Galacs/rpi-canfd-pwr-hat/rpi-canfd-pwr-hat.kicad_pcb

## KiCad design rpi-canfd-pwr-hat.kicad_pcb (2026-06-29)

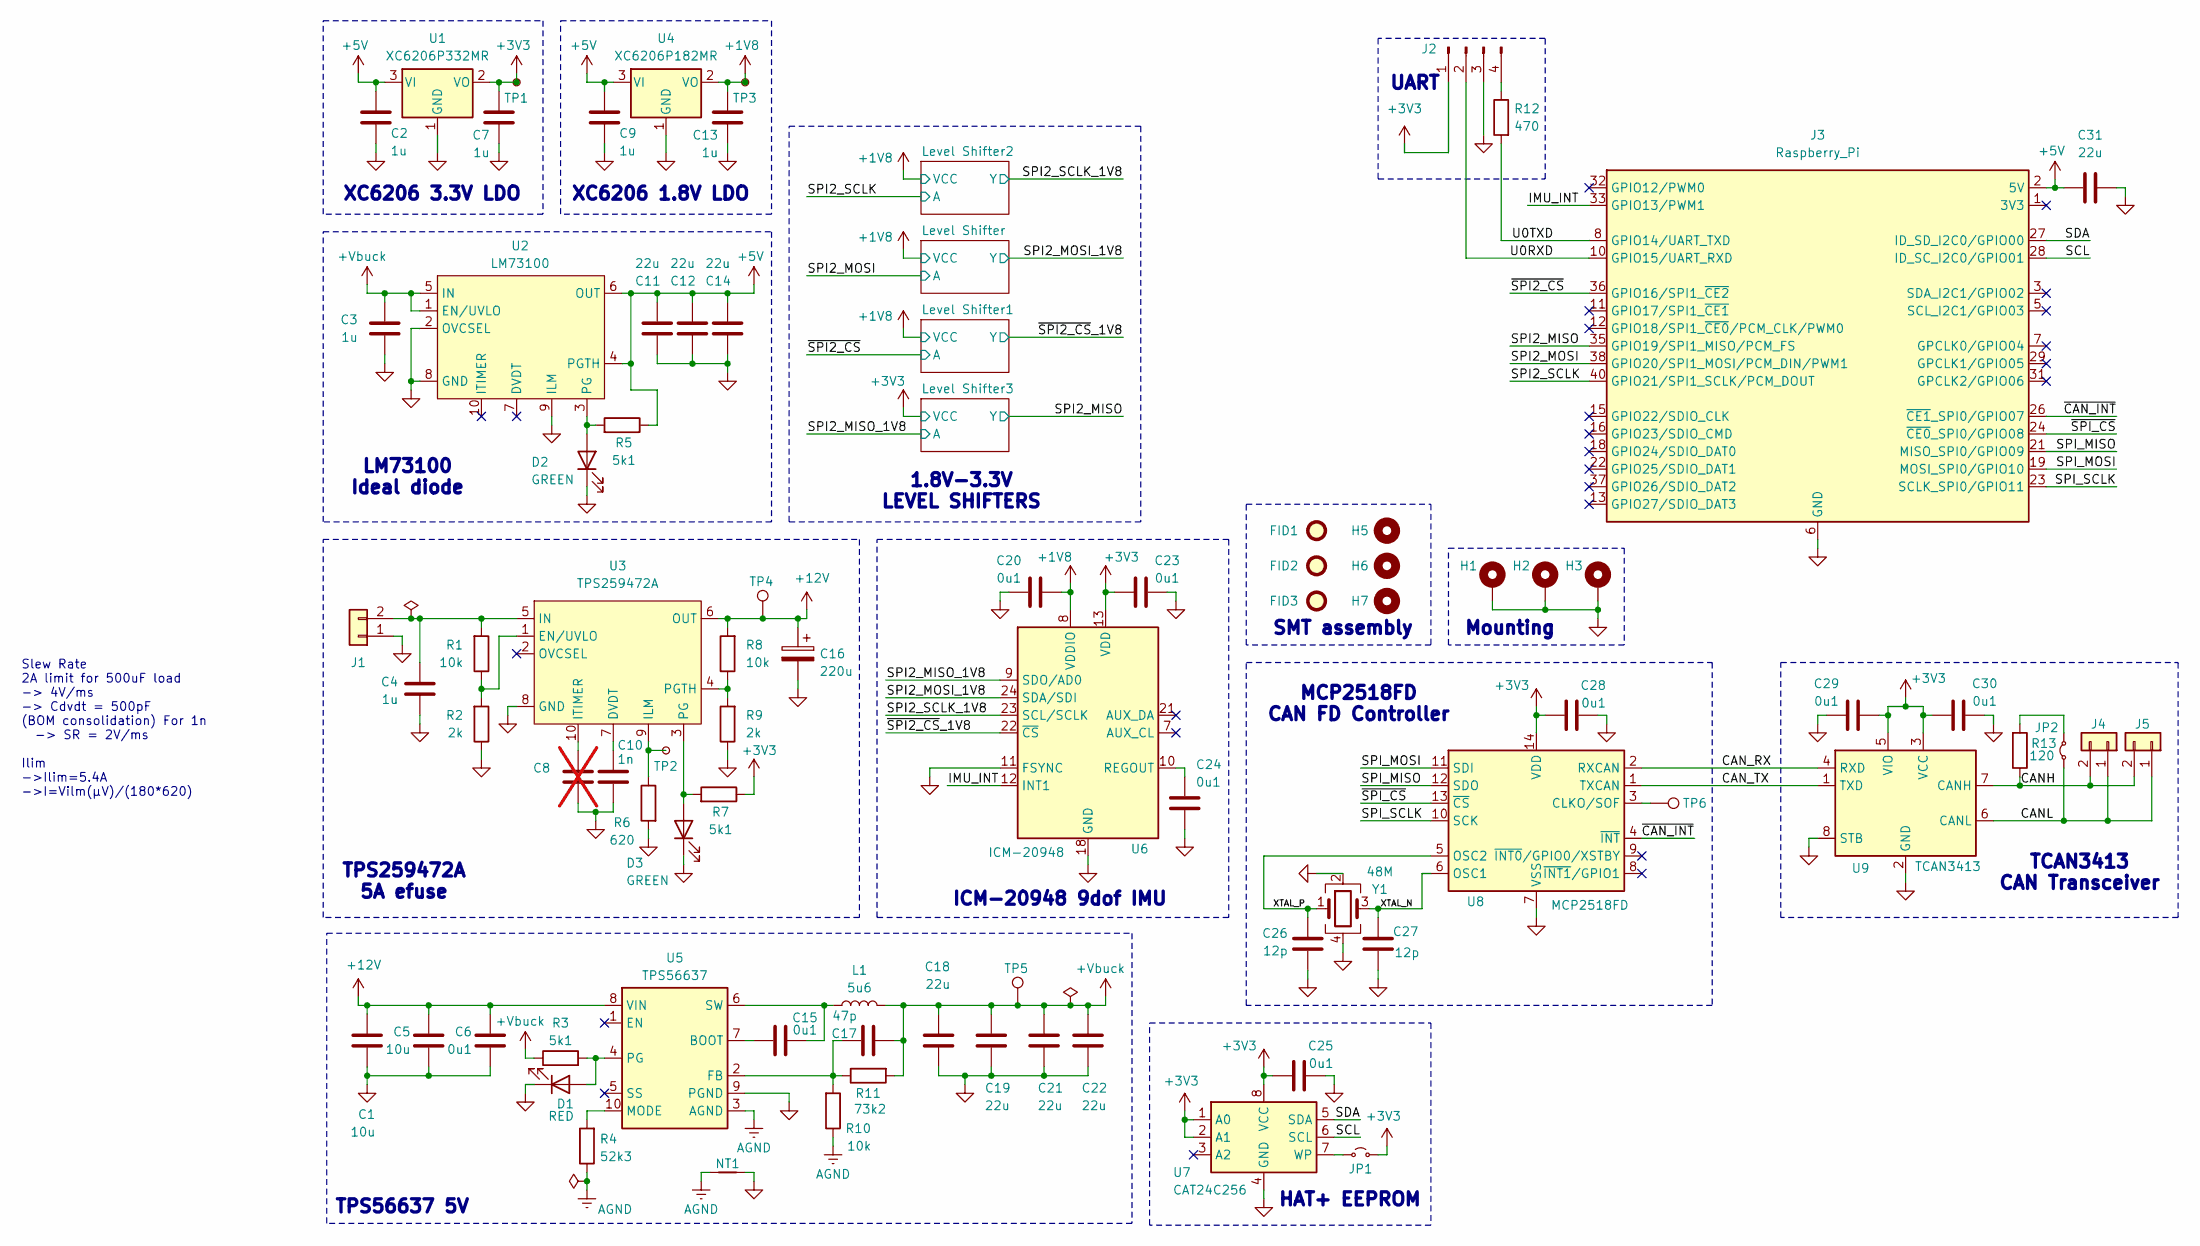
[picture p1: schematic rpi-canfd-pwr-hat.kicad_sch, RPI CAN FD Power Hat+]

Parts:
C1, C5: 10u; C_0805_2012Metric; Manufacturer Part Number GRM21BR61H106KE43L; JLCPCB Part # C440198
C2, C3, C4, C7, C9, C13: 1u; C_0402_1005Metric; Manufacturer Part Number CL05A105KA5NQNC; JLCPCB Part # C52923
C6, C15, C20, C23, C24, C25, C28, C29, C30: 0u1; C_0402_1005Metric; Manufacturer Part Number CL05B104KB54PNC; JLCPCB Part # C307331
C8: C; C_0402_1005Metric; not fitted
C10: 1n; C_0402_1005Metric; Manufacturer Part Number 0402B102K500NT; JLCPCB Part # C1523
C11, C12, C14, C18, C19, C21, C22, C31: 22u; C_0805_2012Metric; Manufacturer Part Number CL21A226MAQNNNE; JLCPCB Part # C45783
C16: 220u; CP_Elec_10x10.5; Manufacturer Part Number 50TZV220M10X10.5; JLCPCB Part # C88818
C17: 47p; C_0402_1005Metric; Manufacturer Part Number 0402CG470J500NT; JLCPCB Part # C1567
C26, C27: 12p; C_0402_1005Metric; Manufacturer Part Number 0402CG120J500NT; JLCPCB Part # C1547
D1: RED; LED_0603_1608Metric; Manufacturer Part Number KT-0603R; JLCPCB Part # C2286
D2, D3: GREEN; LED_0805_2012Metric; Manufacturer Part Number KT-0805G; JLCPCB Part # C2297
FID1, FID2, FID3: Fiducial; Fiducial_1mm_Mask2mm
H1, H2, H3: MountingHole_Pad; MountingHole_2.7mm_M2.5_Pad_Via
H5, H6, H7: MountingHole; ToolingHole_1.152mm
J1, J4, J5: Conn_01x02; JST_XH_B2B-XH-A_1x02_P2.50mm_Vertical; Manufacturer Part Number B2B-XH-A(LF)(SN); JLCPCB Part # C158012
J2: Conn_01x04_Pin; PinHeader_1x04_P2.54mm_Vertical
J3: Raspberry_Pi; PinSocket_2x20_P2.54mm_Vertical
JP1: Jumper_2_Small_Open; SolderJumper-2_P1.3mm_Open_RoundedPad1.0x1.5mm
JP2: Jumper_2_Small_Bridged; PinHeader_1x02_P2.54mm_Horizontal
L1: 5u6; L_Bourns_SRP1050WA; Manufacturer Part Number SMMS1050-5R6M; JLCPCB Part # C149541
NT1: NetTie_2; NetTie-2_SMD_Pad0.5mm
R1, R8, R10: 10k; R_0402_1005Metric; Manufacturer Part Number 0402WGF1002TCE; JLCPCB Part # C25744
R2, R9: 2k; R_0402_1005Metric; Manufacturer Part Number 0402WGF2001TCE; JLCPCB Part # C4109
R3, R5, R7: 5k1; R_0402_1005Metric; Manufacturer Part Number 0402WGF5101TCE; JLCPCB Part # C25905
R4: 52k3; R_0402_1005Metric; Manufacturer Part Number 0402WGF5232TCE; JLCPCB Part # C26982
R6: 620; R_0402_1005Metric; Manufacturer Part Number 0402WGF6200TCE; JLCPCB Part # C4961
R11: 73k2; R_0402_1005Metric; Manufacturer Part Number 0402WGF7322TCE; JLCPCB Part # C26986
R12: 470; R_0402_1005Metric; Manufacturer Part Number 0402WGF4700TCE; JLCPCB Part # C25117
R13: 120; R_1206_3216Metric; Manufacturer Part Number 1206W4F1200T5E; JLCPCB Part # C17909
TP1, TP2, TP3: TestPoint_Small; TestPoint_Pad_D2.0mm
TP4, TP5, TP6: TestPoint; TestPoint_Pad_D2.0mm
U1: XC6206P332MR; SOT-23-3; Manufacturer Part Number XC6206P332MR-G; JLCPCB Part # C5446
U2: LM73100; Texas_RPW0010A_VQFN-HR-10_2x2mm_P0.5mm; Manufacturer Part Number LM73100RPWR; JLCPCB Part # C3210761
U3: TPS259472A; Texas_RPW0010A_VQFN-HR-10_2x2mm_P0.5mm; Manufacturer Part Number TPS259472ARPWR; JLCPCB Part # C3662789
U4: XC6206P182MR; SOT-23-3; Manufacturer Part Number XC6206P182MR; JLCPCB Part # C347373
U5: TPS56637; Texas_RPA0010A_VQFN-HR-10_3x3mm_P0.5mm; Manufacturer Part Number TPS56637RPAR; JLCPCB Part # C841386
U6: ICM-20948; InvenSense_QFN-24_3x3mm_P0.4mm; Manufacturer Part Number ICM-20948; JLCPCB Part # C726001
U7: CAT24C256; SOIC-8_3.9x4.9mm_P1.27mm; Manufacturer Part Number CAT24C256WI-GT3; JLCPCB Part # C79987
U8: MCP2518FD; DFN-14-1EP_3x4.5mm_P0.65mm_EP1.65x4.25mm; Manufacturer Part Number MCP2518FDT-E/QBB; JLCPCB Part # C621395
U9: TCAN3413; TSOT-23-8; Manufacturer Part Number TCAN3413DDFR; JLCPCB Part # C30111221
Y1: 48M; Crystal_SMD_2016-4Pin_2.0x1.6mm; Manufacturer Part Number R940000096; JLCPCB Part # C7206306

Connections:
+1V8: C13.2, C20.1, TP3.1 (1_1), U4.2 (VO), U6.8 (VDDIO); also elsewhere on the board
+3V3: C7.2, C23.1, C25.1, C28.1, C29.1, C30.1, J2.1, JP1.2 (B), R7.1, TP1.1 (1_1), U1.2 (VO), U6.13 (VDD), U7.1 (A0), U7.2 (A1), U7.8 (VCC), U8.14 (VDD), U9.3 (VCC), U9.5 (VIO); also elsewhere on the board
+5V: C2.2, C9.2, C11.2, C12.2, C14.2, C31.1, J3.2 (5V), J3.4 (5V), R5.1, U1.3 (VI), U2.4 (PGTH), U2.6 (OUT), U4.3 (VI)
+12V: C1.1, C5.1, C6.1, C16.1, R8.2, TP4.1 (1_1), U3.6 (OUT), U5.8 (VIN)
+Vbuck: C3.2, C17.2, C18.1, C19.1, C21.1, C22.1, L1.2, R3.1, R11.2, TP5.1 (1_1), U2.1 (EN/UVLO), U2.5 (IN)
/CANH: J4.2, J5.2, R13.1, U9.7 (CANH)
/CANL: J4.1, J5.1, JP2.1 (A), U9.6 (CANL)
/CAN_RX: U8.2 (RXCAN), U9.4 (RXD)
/CAN_TX: U8.1 (TXCAN), U9.1 (TXD)
/IMU_INT: J3.33 (GPIO13/PWM1), U6.12 (INT1)
/SCL: J3.28 (ID_SC_I2C0/GPIO01), U7.6 (SCL)
/SDA: J3.27 (ID_SD_I2C0/GPIO00), U7.5 (SDA)
/SPI2_MISO: J3.35 (GPIO19/SPI1_MISO/PCM_FS); also elsewhere on the board
/SPI2_MISO_1V8: U6.9 (SDO/AD0); also elsewhere on the board
/SPI2_MOSI: J3.38 (GPIO20/SPI1_MOSI/PCM_DIN/PWM1); also elsewhere on the board
/SPI2_MOSI_1V8: U6.24 (SDA/SDI); also elsewhere on the board
/SPI2_SCLK: J3.40 (GPIO21/SPI1_SCLK/PCM_DOUT); also elsewhere on the board
/SPI2_SCLK_1V8: U6.23 (SCL/SCLK); also elsewhere on the board
/SPI_MISO: J3.21 (MISO_SPI0/GPIO09), U8.12 (SDO)
/SPI_MOSI: J3.19 (MOSI_SPI0/GPIO10), U8.11 (SDI)
/SPI_SCLK: J3.23 (SCLK_SPI0/GPIO11), U8.10 (SCK)
/U0RXD: J2.2, J3.10 (GPIO15/UART_RXD)
/U0TXD: J3.8 (GPIO14/UART_TXD), R12.2
/XTAL_N: C27.1, U8.6 (OSC1), Y1.3
/XTAL_P: C26.2, U8.5 (OSC2), Y1.1
/~CAN_INT: J3.26 (~CE1_SPI0/GPIO07), U8.4 (~INT)
/~SPI2_CS: J3.36 (GPIO16/SPI1_~CE2); also elsewhere on the board
/~SPI2_CS_1V8: U6.22 (~CS); also elsewhere on the board
/~SPI_CS: J3.24 (~CE0_SPI0/GPIO08), U8.13 (~CS)
AGND: NT1.1, R4.1, R10.1, U5.3 (AGND)
GND: C1.2, C2.1, C3.1, C4.1, C5.2, C6.2, C7.1, C8.2, C9.1, C10.2, C11.1, C12.1, C13.1, C14.1, C16.2, C18.2, C19.2, C20.2, C21.2, C22.2, C23.2, C24.2, C25.2, C26.1, C27.2, C28.2, C29.2, C30.2, C31.2, D1.1 (K), D2.1 (K), D3.1 (K), H1.1 (1_1), H2.1 (1_1), H3.1 (1_1), J1.1, J2.3, J3.6 (GND), J3.9 (GND), J3.14 (GND), J3.20 (GND), J3.25 (GND), J3.30 (GND), J3.34 (GND), J3.39 (GND), NT1.2, R2.1, R6.2, R9.1, U1.1 (GND), U2.2 (OVCSEL), U2.8 (GND), U2.9 (ILM), U3.8 (GND), U4.1 (GND), U5.9 (PGND), U6.11 (FSYNC), U6.18 (GND), U6.20 (GND), U7.4 (GND), U8.7 (VSS), U8.15 (VSS), U9.2 (GND), U9.8 (STB), Y1.2, Y1.4; also elsewhere on the board
unnamed: D1.2 (A), R3.2, U5.4 (PG)
unnamed: D2.2 (A), R5.2, U2.3 (PG)
unnamed: D3.2 (A), R7.2, U3.3 (PG)
unnamed: C4.2, J1.2, R1.2, U3.5 (IN)
unnamed: J2.4, R12.1
unnamed: JP1.1 (A), U7.7 (WP)
unnamed: JP2.2 (B), R13.2
unnamed: C10.1, U3.7 (DVDT)
unnamed: R1.1, R2.2, U3.1 (EN/UVLO)
unnamed: R6.1, TP2.1 (1_1), U3.9 (ILM)
unnamed: C8.1, U3.10 (ITIMER)
unnamed: R8.1, R9.2, U3.4 (PGTH)
unnamed: C15.1, U5.7 (BOOT)
unnamed: C17.1, R10.2, R11.1, U5.2 (FB)
unnamed: R4.2, U5.10 (MODE)
unnamed: C15.2, L1.1, U5.6 (SW)
unnamed: C24.1, U6.10 (REGOUT)
unnamed: TP6.1 (1_1), U8.3 (CLKO/SOF)

Notes on the sheet:
1.8V-3.3V LEVEL SHIFTERS
HAT+ EEPROM
Mounting
XC6206 1.8V LDO
TCAN3413 CAN Transceiver
Slew Rate 2A limit for 500uF load -> 4V/ms -> Cdvdt = 500pF (BOM consolidation) For 1n -> SR = 2V/ms Ilim ->Ilim=5.4A ->I=Vilm(µV)/(180*620)
LM73100 Ideal diode
XC6206 3.3V LDO
UART
TPS259472A 5A efuse
MCP2518FD CAN FD Controller
TPS56637 5V
ICM-20948 9dof IMU
SMT assembly

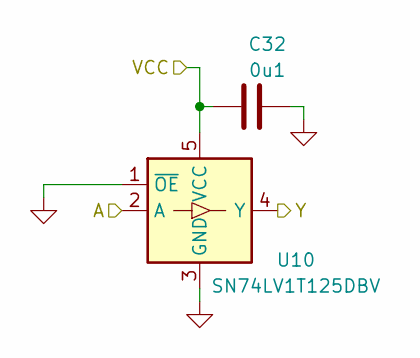
[picture p2: schematic level-shifter.kicad_sch, RPI CAN FD Power Hat+]

Parts:
C32: 0u1; C_0402_1005Metric; Manufacturer Part Number CL05B104KB54PNC; JLCPCB Part # C307331
U10: SN74LV1T125DBV; SOT-23-5; Manufacturer Part Number SN74LV1T125DBVR; JLCPCB Part # C473338

Connections:
+1V8: C32.1, U10.5 (VCC); also elsewhere on the board
/SPI2_MOSI: U10.2 (A); also elsewhere on the board
/SPI2_MOSI_1V8: U10.4 (Y); also elsewhere on the board
GND: C32.2, U10.1 (~OE), U10.3 (GND); also elsewhere on the board

Parts of its further copies:
C33, C34, C35: 0u1; C_0402_1005Metric; Manufacturer Part Number CL05B104KB54PNC; JLCPCB Part # C307331
U11, U12, U13: SN74LV1T125DBV; SOT-23-5; Manufacturer Part Number SN74LV1T125DBVR; JLCPCB Part # C473338

Connections of its further copies:
+1V8: C33.1, C34.1, U11.5 (VCC), U12.5 (VCC); also elsewhere on the board
+3V3: C35.1, U13.5 (VCC); also elsewhere on the board
/SPI2_MISO: U13.4 (Y); also elsewhere on the board
/SPI2_MISO_1V8: U13.2 (A); also elsewhere on the board
/SPI2_SCLK: U12.2 (A); also elsewhere on the board
/SPI2_SCLK_1V8: U12.4 (Y); also elsewhere on the board
/~SPI2_CS: U11.2 (A); also elsewhere on the board
/~SPI2_CS_1V8: U11.4 (Y); also elsewhere on the board
GND: C33.2, C34.2, C35.2, U11.1 (~OE), U11.3 (GND), U12.1 (~OE), U12.3 (GND), U13.1 (~OE), U13.3 (GND); also elsewhere on the board

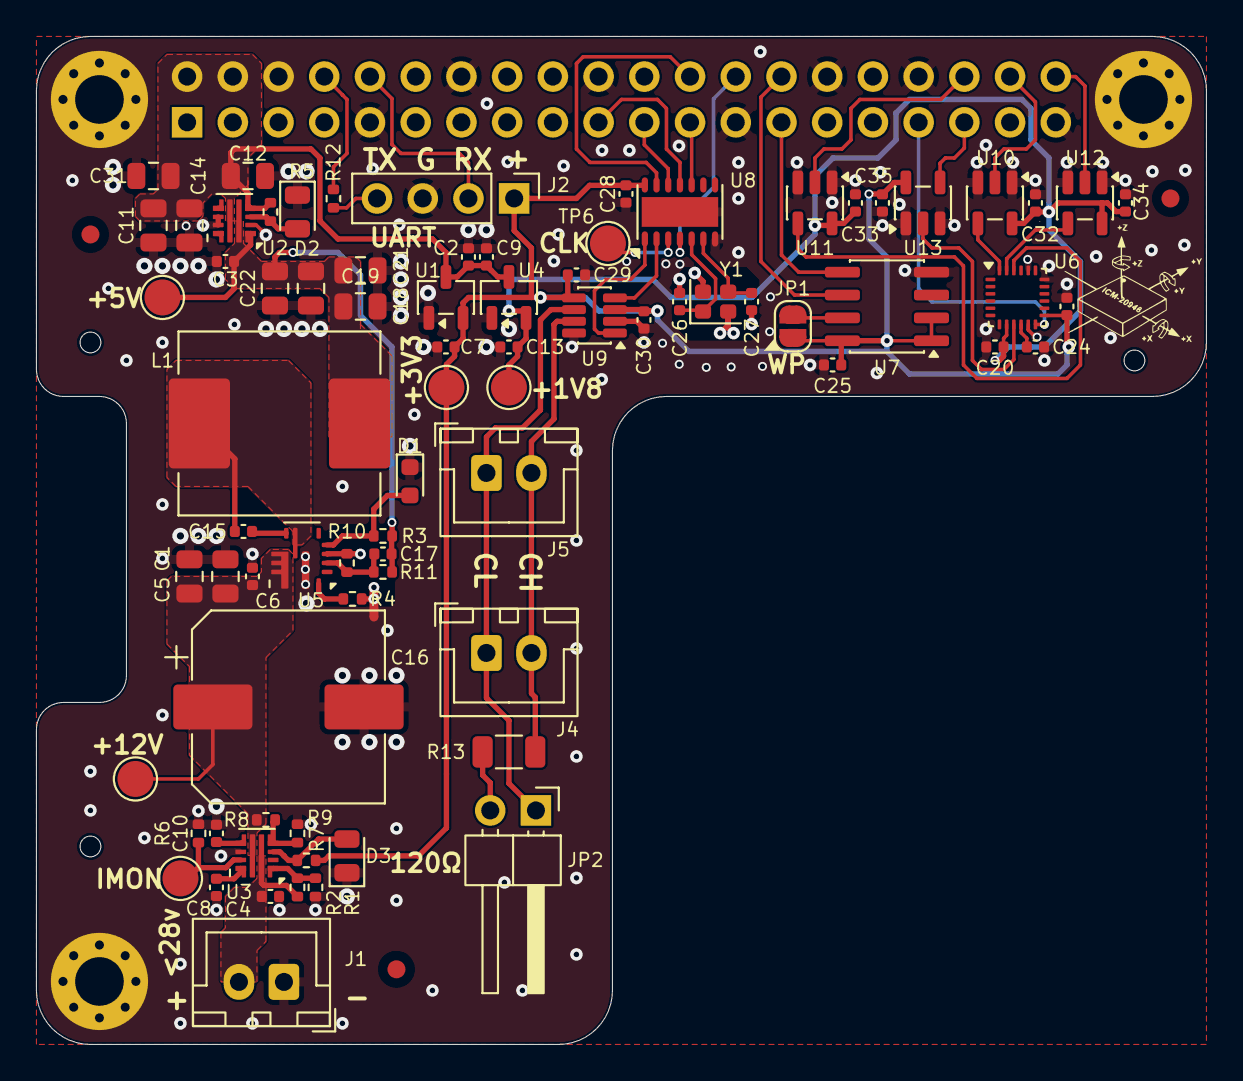
[picture p3: board rpi-canfd-pwr-hat.kicad_pcb from above]

Board: 4 copper layers, 65.0 x 56.0 mm, 89 parts (1 on the bottom side), 49 nets.
