Galacs/rpi-canfd-pwr-hat/(commit log)

2026-06-27 schem: add eeprom power hat+
    [rpi-canfd-pwr-hat.kicad_sch]
2026-06-27 schem: add uart connector
    [rpi-canfd-pwr-hat.kicad_sch]
2026-06-27 schem: add TPS56637 5v buck converter
    [rpi-canfd-pwr-hat.kicad_sch]
2026-06-27 schem: add LM73100 Ideal diode
    [rpi-canfd-pwr-hat.kicad_sch]
2026-06-27 schem: add TPS259472A 5A efuse
    [rpi-canfd-pwr-hat.kicad_sch]
2026-06-27 schem: fix ufuse uvlo and pgth
    [rpi-canfd-pwr-hat.kicad_sch]
2026-06-27 schem: remove i2c pullups
    [rpi-canfd-pwr-hat.kicad_sch]
2026-06-27 schem: add MCP2518FD CAN FD Controller
    [rpi-canfd-pwr-hat.kicad_sch]
2026-06-27 schem: add TCAN3413 CAN Transceiver
    [rpi-canfd-pwr-hat.kicad_sch]
2026-06-28 schem: add ICM-20948 9dof IMU and level shifters
    [level-shifter.kicad_sch, rpi-canfd-pwr-hat.kicad_sch]
2026-06-28 schem: add XC6206 3.3V LDO
    [rpi-canfd-pwr-hat.kicad_sch]
2026-06-28 schem: add XC6206 1.8V LDO
    [rpi-canfd-pwr-hat.kicad_sch]
2026-06-28 schem: update TPS56637 datasheet
    [rpi-canfd-pwr-hat.kicad_sch]
2026-06-28 schem: add no connects
    [rpi-canfd-pwr-hat.kicad_sch]
2026-06-28 schem: assign missing footprints
    [rpi-canfd-pwr-hat.kicad_sch]
2026-06-28 schem: add ordering info to BOM
    [rpi-canfd-pwr-hat.kicad_sch]
2026-06-28 schem: add title
    [level-shifter.kicad_sch, rpi-canfd-pwr-hat.kicad_sch]
2026-06-28 schem: renumber
    [level-shifter.kicad_sch, rpi-canfd-pwr-hat.kicad_sch]
2026-06-28 pcb: import jlc 4 layer stackup
    [rpi-canfd-pwr-hat.kicad_pcb]
2026-06-28 pcb: import components from schem
    [rpi-canfd-pwr-hat.kicad_pcb]
2026-06-28 pcb: add missing 3d models
    [rpi-canfd-pwr-hat.kicad_pcb]
2026-06-28 pcb: initial sectionning
    [rpi-canfd-pwr-hat.kicad_pcb]
2026-06-28 schem: add smt fiducials and tooling holes
    [rpi-canfd-pwr-hat.kicad_sch]
2026-06-28 schem: add hat mounting holes
    [rpi-canfd-pwr-hat.kicad_sch]
2026-06-28 pcb: add hat outline
    [rpi-canfd-pwr-hat.kicad_pcb]
2026-06-28 pcb: add can layout
    [rpi-canfd-pwr-hat.kicad_pcb]
2026-06-28 pcb: add imu layout
    [rpi-canfd-pwr-hat.kicad_pcb]
2026-06-28 pcb: add eeprom routing
    [rpi-canfd-pwr-hat.kicad_pcb]
2026-06-28 pcb: add smps layout
    [rpi-canfd-pwr-hat.kicad_pcb, rpi-canfd-pwr-hat.kicad_sch]
2026-06-28 pcb: add smps zone
    [rpi-canfd-pwr-hat.kicad_pcb]
2026-06-28 pcb: add input efuse routing
    [rpi-canfd-pwr-hat.kicad_pcb]
2026-06-28 pcb: update board outline
    [rpi-canfd-pwr-hat.kicad_pcb, rpi-canfd-pwr-hat.kicad_sch]
2026-06-28 pcb: final board layout
    [rpi-canfd-pwr-hat.kicad_pcb]
2026-06-28 pcb: add gnd planes
    [rpi-canfd-pwr-hat.kicad_pcb]
2026-06-28 pcb: add gnd vias
    [rpi-canfd-pwr-hat.kicad_pcb]
2026-06-28 pcb: add drill/place origin
    [rpi-canfd-pwr-hat.kicad_pcb]
2026-06-28 pcb: add xtal routing
    [rpi-canfd-pwr-hat.kicad_pcb]
2026-06-28 pcb: route imu
    [rpi-canfd-pwr-hat.kicad_pcb, rpi-canfd-pwr-hat.kicad_sch]
2026-06-28 pcb: route eeprom
    [rpi-canfd-pwr-hat.kicad_pcb]
2026-06-28 pcb: route input efuse
    [rpi-canfd-pwr-hat.kicad_pcb]
2026-06-28 pcb: route rpi power path
    [rpi-canfd-pwr-hat.kicad_pcb]
2026-06-28 pcb: route uart
    [rpi-canfd-pwr-hat.kicad_pcb]
2026-06-28 pcb: route ldos
    [rpi-canfd-pwr-hat.kicad_pcb]
2026-06-28 pcb: route can
    [rpi-canfd-pwr-hat.kicad_pcb, rpi-canfd-pwr-hat.kicad_sch]
2026-06-28 pcb: route +1v8 pwr
    [rpi-canfd-pwr-hat.kicad_pcb]
2026-06-28 pcb: add stitching vias
    [rpi-canfd-pwr-hat.kicad_pcb]
2026-06-28 pcb: run and fix DRC
    [rpi-canfd-pwr-hat.kicad_pcb]
2026-06-28 pcb: remove unuse dinternal pads
    [rpi-canfd-pwr-hat.kicad_pcb]
2026-06-28 pcb(silk): clean reference designators
    [rpi-canfd-pwr-hat.kicad_pcb]
2026-06-28 pcb(silk): add usr txt
    [rpi-canfd-pwr-hat.kicad_pcb]
2026-06-28 pcb: add title
    [rpi-canfd-pwr-hat.kicad_pcb]
2026-06-28 generate production files
    [bom.csv, designators.csv, positions.csv, rpi-canfd-pwr-hat.kicad_pcb, rpi-canfd-pwr-hat.kicad_sch]
2026-06-29 schem/pcb: switch to phat rubycon cap
    [rpi-canfd-pwr-hat.kicad_pcb, rpi-canfd-pwr-hat.kicad_sch]
2026-06-30 regenerate production files
    [bom.csv, designators.csv, positions.csv]
